pradnyas5/Miniature-Hexapod/README.md

# Miniature-Hexapod
Developed an updated miniature version of Hextorq(Six-legged Robot), a product of a Pune-based startup, Technodune Pvt. Ltd.

mini

*Miniature-Hexapod*

Hextorq

*Previous version, "Hextorq" designed by **[Technodune Pvt. Ltd.](http://technodune.com/)**.*

To develop the robot, the initial stage consisted of choosing an appropriate Servo Motor for effective locomotion. The "ServoTestCode.ino" file consists of the base code used to analyze the performance of various servo motors. 

To know more, PLEASE FIND THE TECHNICAL DETAILS OF THE PROJECT IN THE FILE NAMED, "MiniHexProjectReport.pdf" PROVIDED ABOVE.
